eumorpurgo/TextileDrawingMachine/contours/src/circleincircle.png

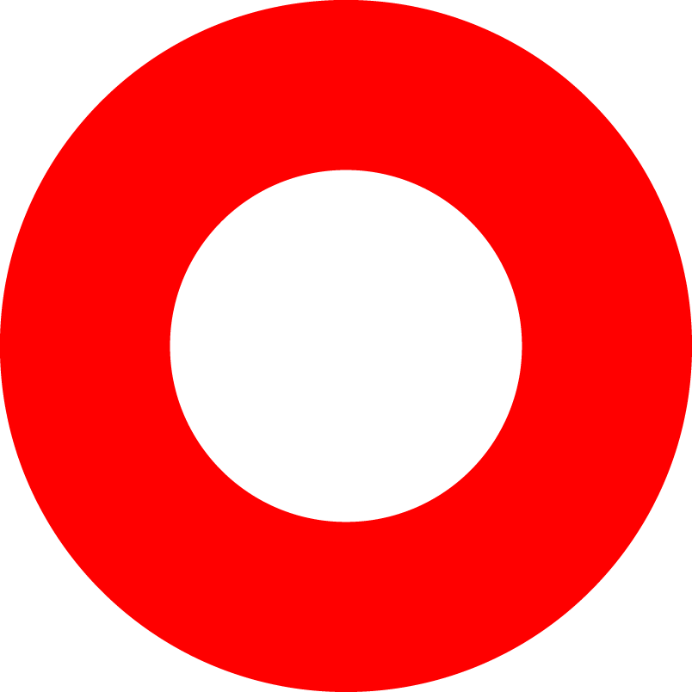
contours/src/circleincircle.png
