eumorpurgo/TextileDrawingMachine/contours/src/DRUST.png

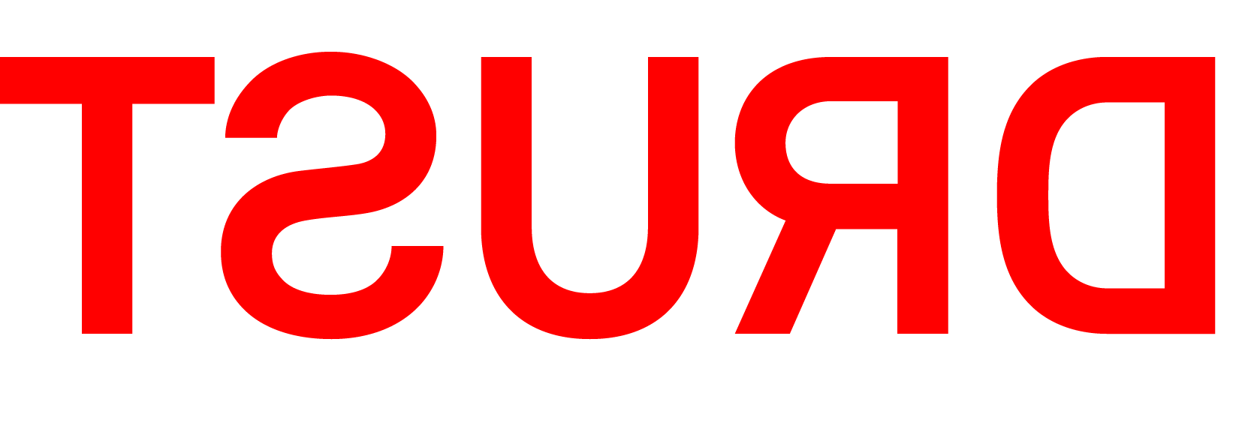
contours/src/DRUST.png
