eumorpurgo/TextileDrawingMachine/contours/src/jokercontourssvg.png

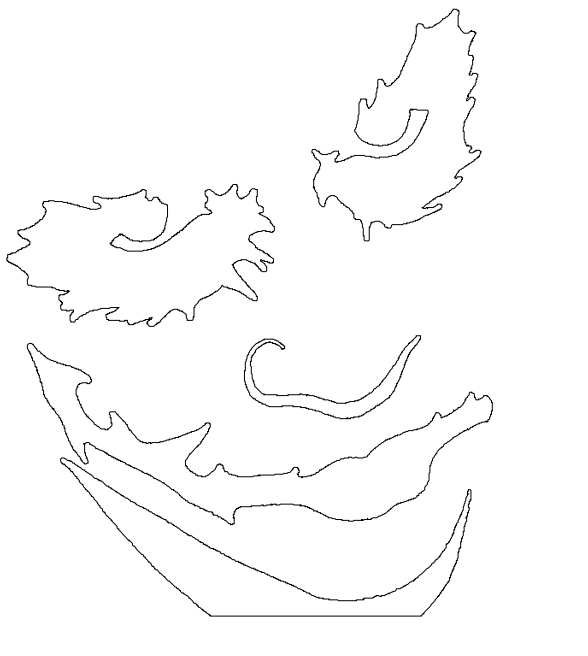
contours/src/jokercontourssvg.png
