eumorpurgo/TextileDrawingMachine/contours/src/lines.png

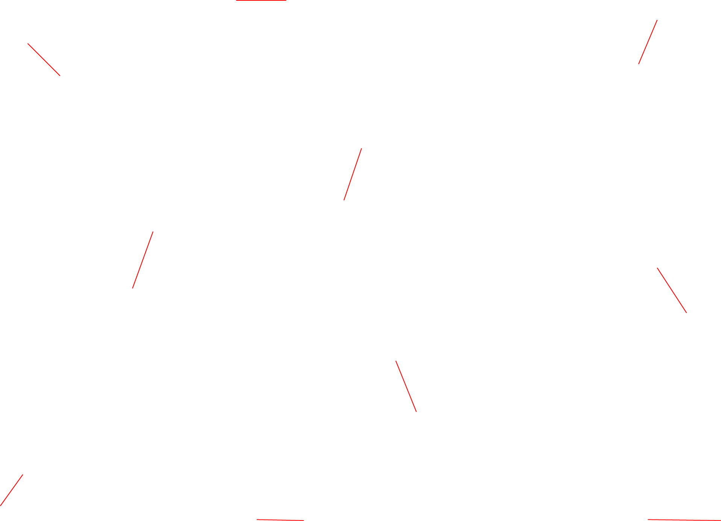
contours/src/lines.png
