eumorpurgo/TextileDrawingMachine/contours/src/linessimple.png

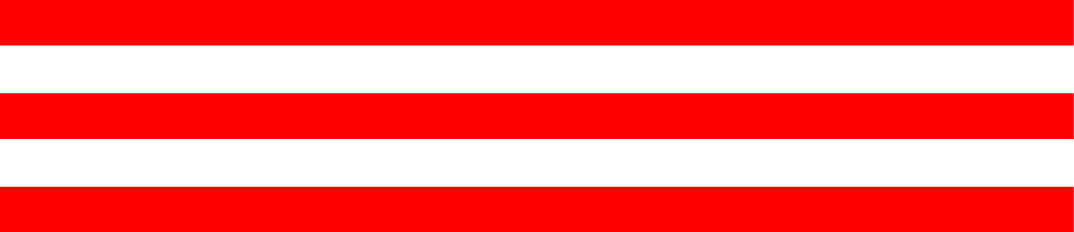
contours/src/linessimple.png
