eumorpurgo/TextileDrawingMachine/drawings/images/circles.png

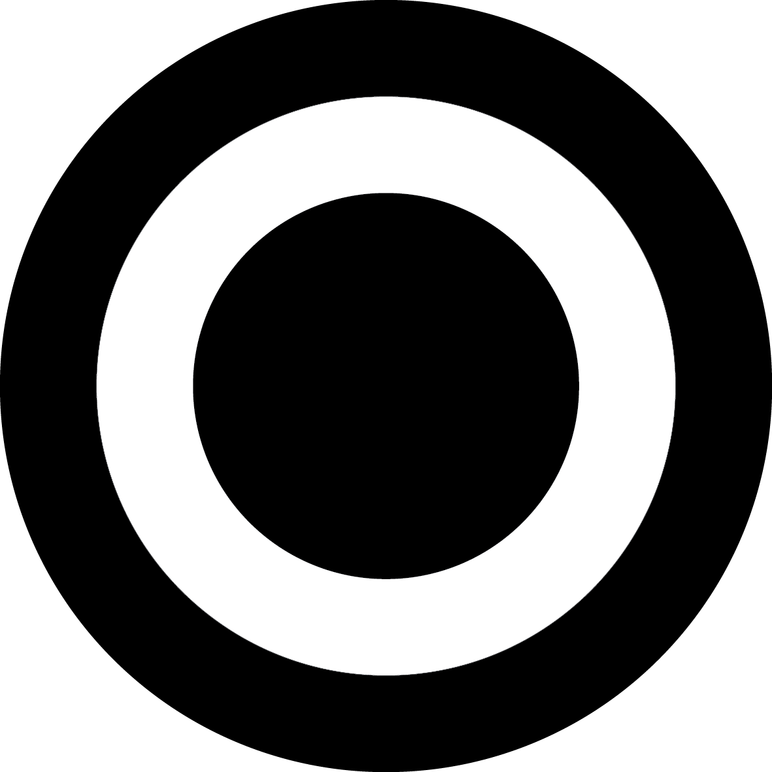
drawings/images/circles.png
