eumorpurgo/TextileDrawingMachine/drawings/images/squares.png

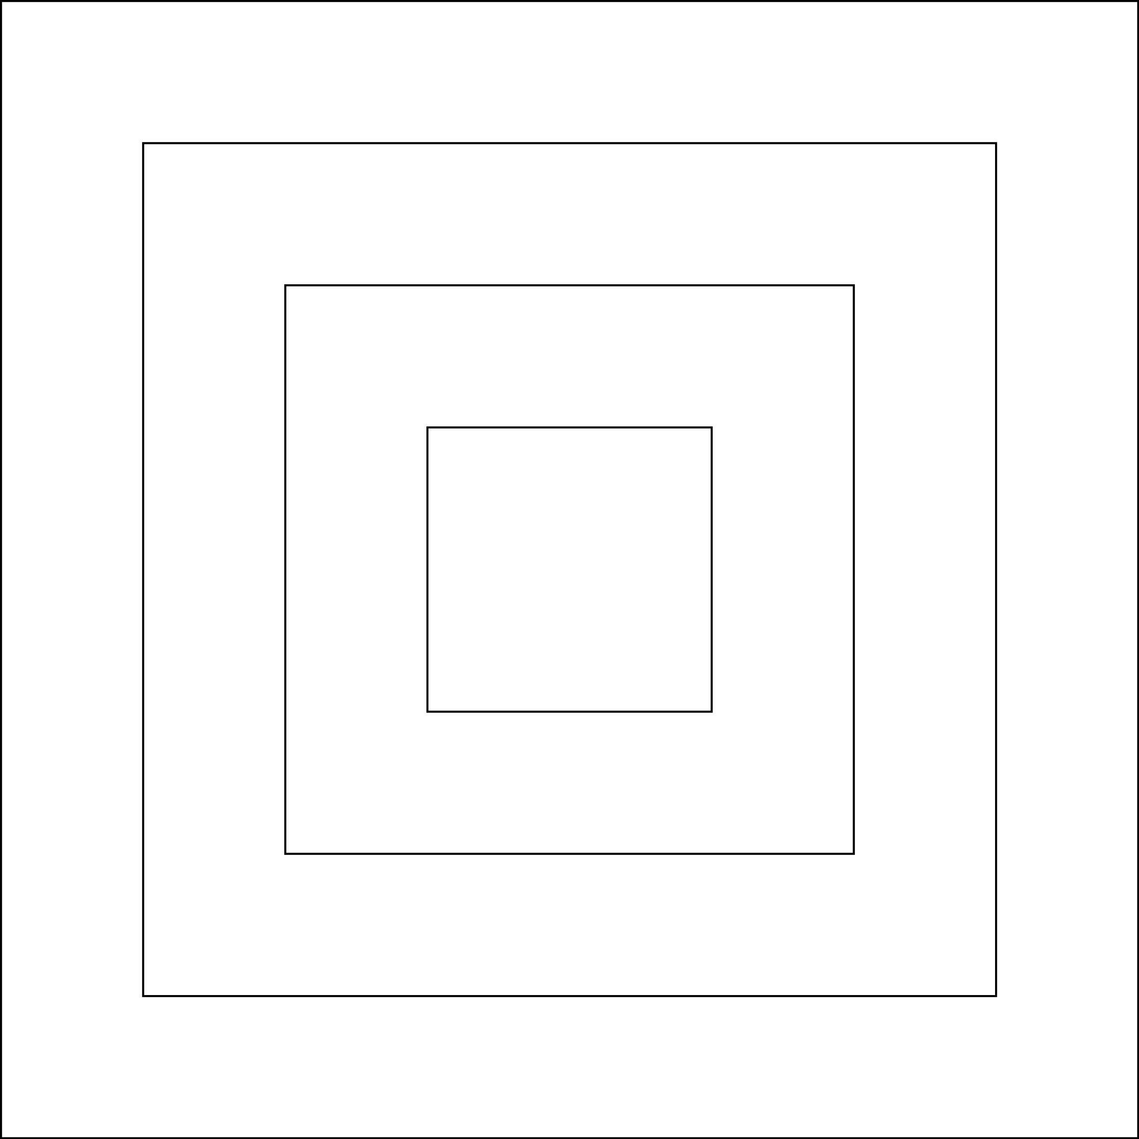
drawings/images/squares.png
