eumorpurgo/TextileDrawingMachine/frontend/data/uploads/circle.png

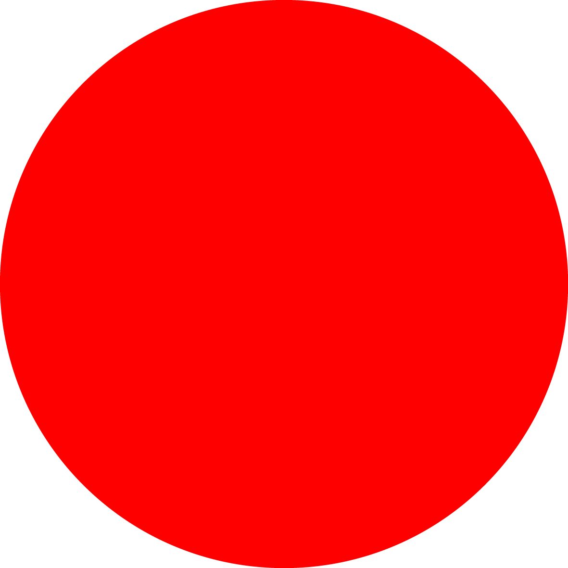
frontend/data/uploads/circle.png
