eumorpurgo/TextileDrawingMachine/Imgs_Instruction/Cables1.jpg

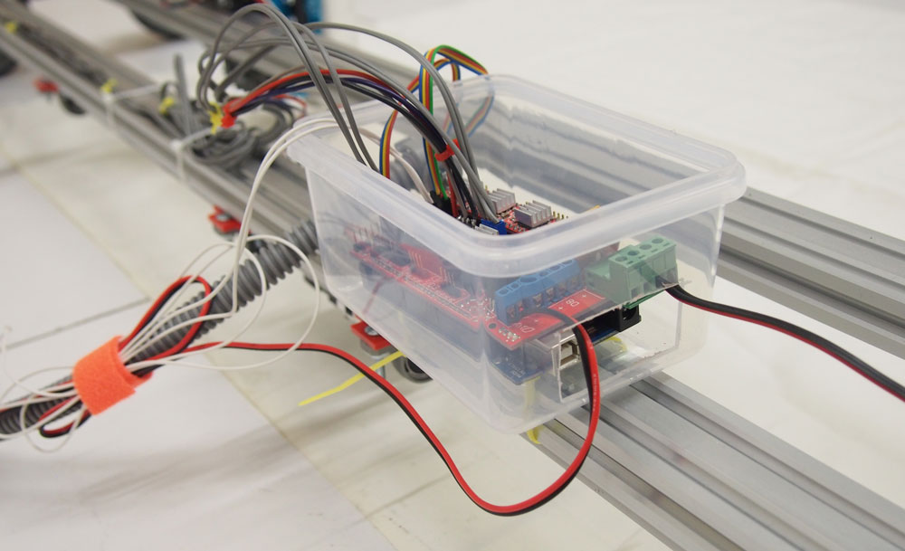
Imgs_Instruction/Cables1.jpg
