eumorpurgo/TextileDrawingMachine/Imgs_Instruction/Heatsink.jpg

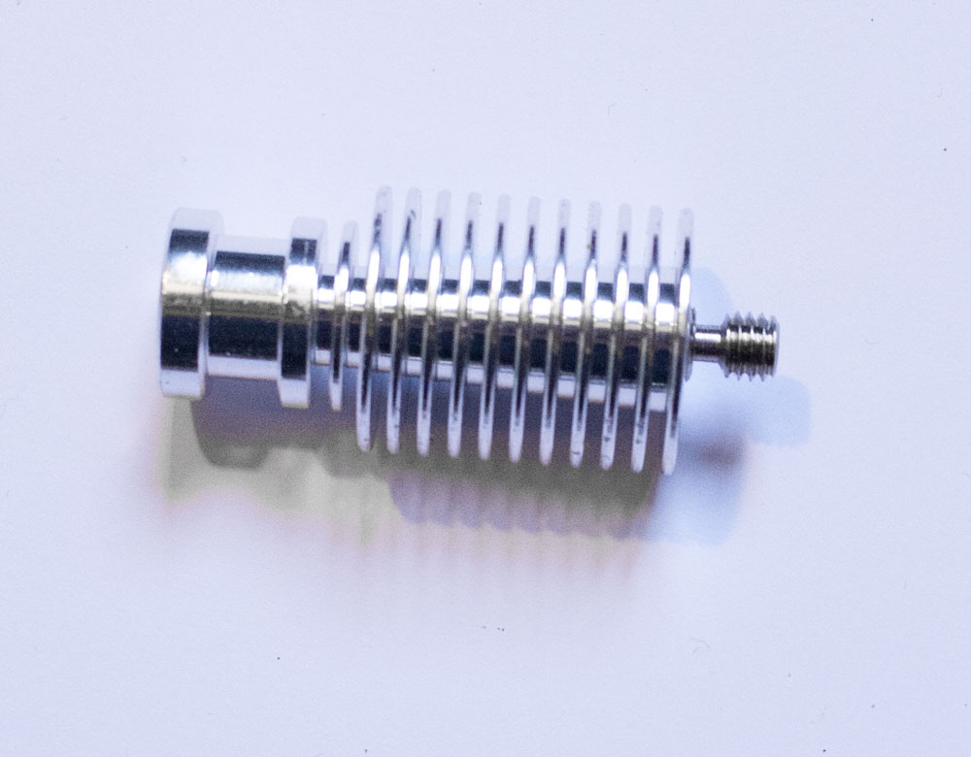
Imgs_Instruction/Heatsink.jpg
