eumorpurgo/TextileDrawingMachine/Imgs_Instruction/AdapterTextileMachine.pdf

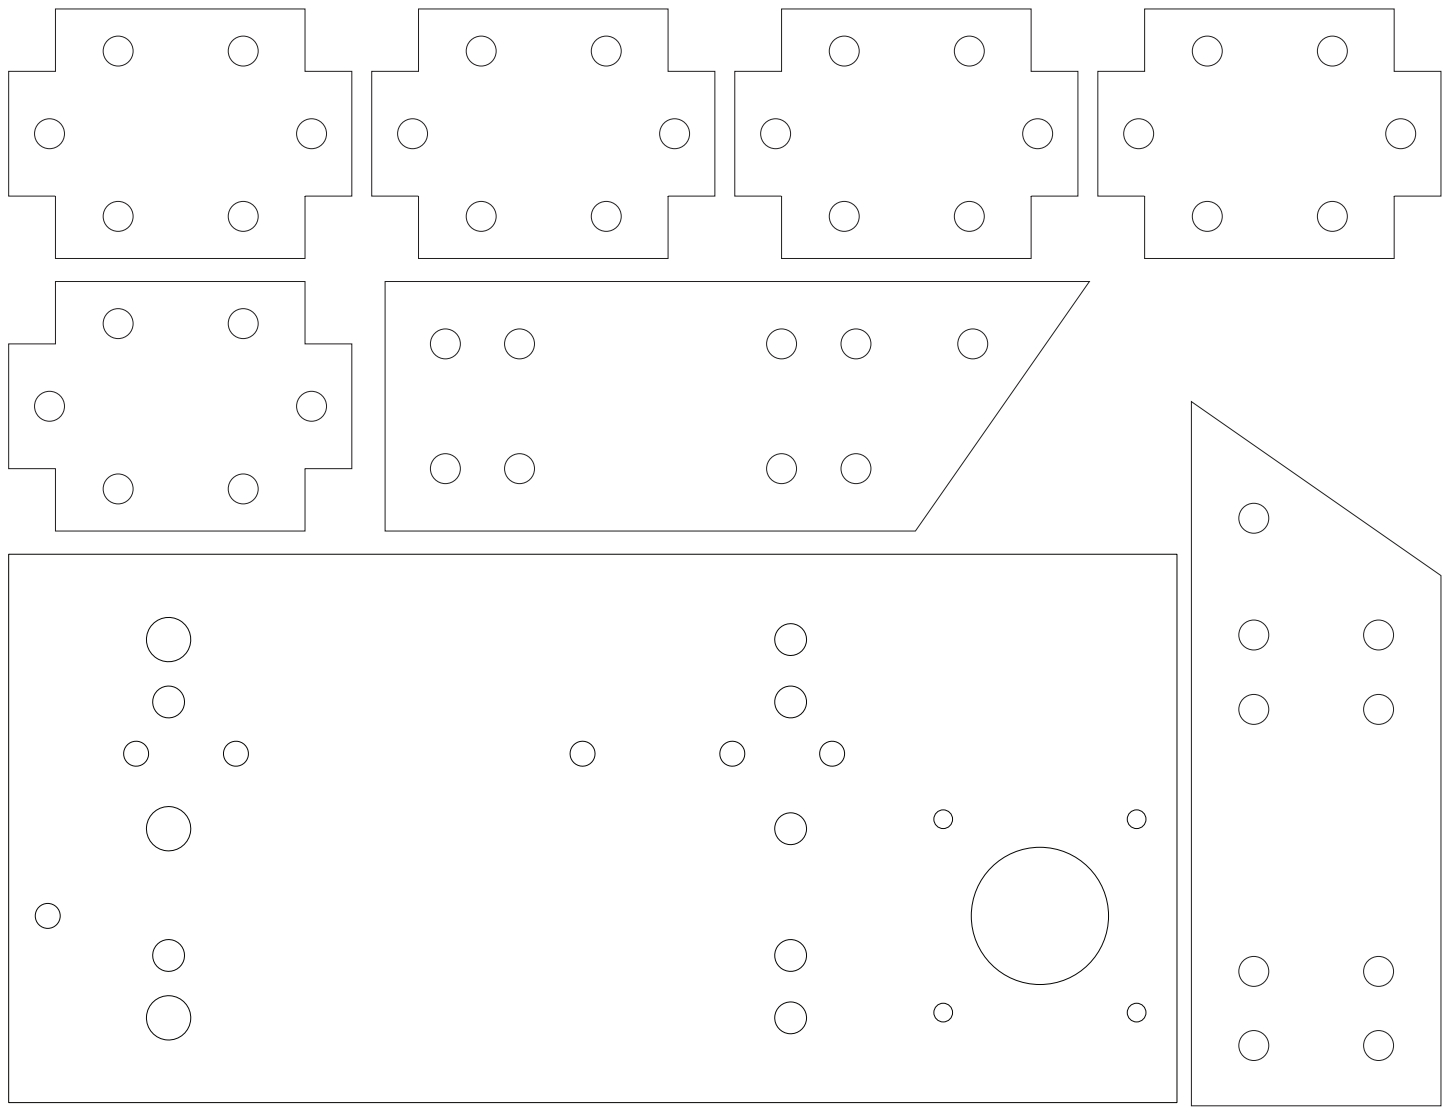
[picture p54: page 1]
