eumorpurgo/TextileDrawingMachine/(commit log)

2018-03-15 Initial commit
    Code and documentation for Textile Drawing Machine
    [Configuration.h, Configuration_adv.h]
2018-08-26 Add File Adapters
    Added dxf file adapters to lasercut or cnc
2019-04-03 Add documentation for firmware changes
    [Configuration.h, Configuration_adv.h]
2019-04-03 Add configuration files for marlin 1.1.9
    [Configuration.h, Configuration_adv.h]
2020-02-26 Add configuration files for Marlin 2.0.x
    [Configuration.h, Configuration_adv.h]
